madhavkrishnanks/assistive-rotary-keyboard/(commit log)

2026-08-20 Revise README with detailed project information
    Expanded the README to provide detailed information about the assistive rotary keyboard, including features, hardware components, wiring, firmware requirements, project status, motivation, and licensing.
2026-11-07 docs: add user testing photos, prototype assets, and update README
2026-11-07 docs: add KiCad circuit schematic and CAD project files
    [SmartAssistiveKeyboard.kicad_sch]
